CreatOurCar/monolith/device/hardware/monolith-mini/monolith-mini.kicad_pcb

## KiCad design device/hardware/monolith-mini/monolith-mini.kicad_pcb (2025-08-28, last stored version)

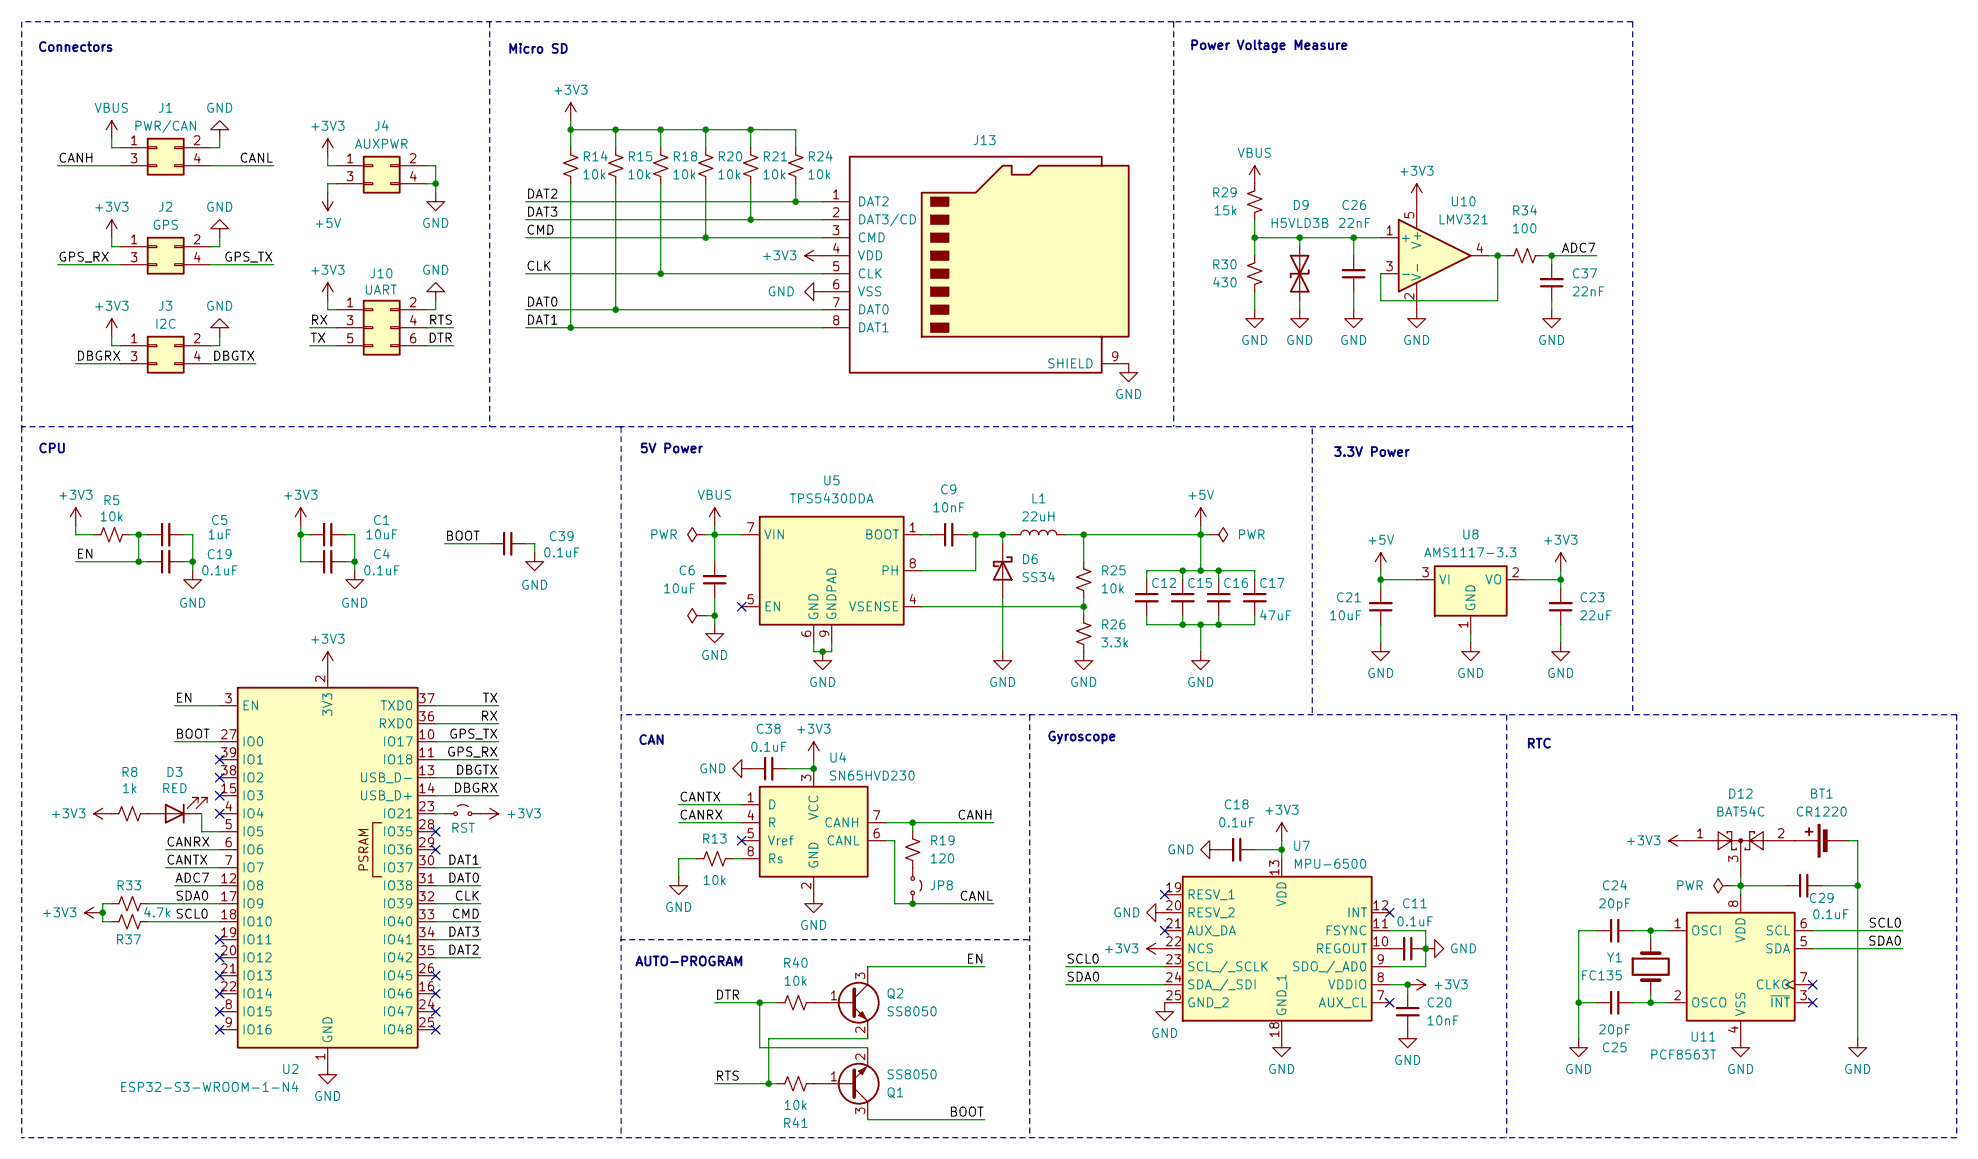
[picture p8: schematic monolith-mini.kicad_sch]

Parts:
BT1: CR1220; S8411-45R_1; Manufacturer_Part_Number CR1220-2; LCSC C70381
C1, C21: 10uF; C_0603_1608Metric; LCSC C19702
C4, C11, C18, C19, C29, C38, C39: 0.1uF; C_0603_1608Metric; LCSC C14663
C5: 1uF; C_0603_1608Metric; LCSC C15849
C6: 10uF; C_1206_3216Metric; LCSC C13585
C9, C20: 10nF; C_0603_1608Metric; LCSC C57112
C12, C15, C16, C17: 47uF; C_1206_3216Metric; LCSC C96123
C23: 22uF; C_0603_1608Metric; LCSC C59461
C24, C25: 20pF; C_0603_1608Metric; LCSC C1648
C26, C37: 22nF; C_0603_1608Metric; LCSC C21122
D3: RED; LED_0603_1608Metric; LCSC C2286
D6: SS34; D_SMA; LCSC C8678
D9: H5VLD3B; D_SOD-323; LCSC C20615805
D12: BAT54C; SOT-23; Manufacturer_Part_Number BAT54C; LCSC C37704
J1: PWR/CAN; Molex_Mini-Fit_Jr_5569-04A2_2x02_P4.20mm_Horizontal
J2: GPS; Molex_Mini-Fit_Jr_5569-04A2_2x02_P4.20mm_Horizontal
J3: I2C; Molex_Mini-Fit_Jr_5569-04A2_2x02_P4.20mm_Horizontal
J4: AUXPWR; Molex_Mini-Fit_Jr_5569-04A2_2x02_P4.20mm_Horizontal
J10: UART; PinHeader_2x03_P2.54mm_Vertical
J13: Micro_SD_Card; TF115BCP9; LCSC C393941
JP5: RST; PinHeader_1x02_P2.54mm_Vertical
JP8: CAN 120Ω; PinHeader_1x02_P2.54mm_Vertical
L1: 22uH; L_Sunlord_MWSA0603S; LCSC C177244
Q1, Q2: SS8050; SOT-23; LCSC C2150
R5, R13, R14, R15, R18, R20, R21, R24, R25, R40, R41: 10k; R_0603_1608Metric; LCSC C25804
R8: 1k; R_0603_1608Metric; LCSC C21190
R19: 120; R_0603_1608Metric; LCSC C22787
R26: 3.3k; R_0603_1608Metric; LCSC C22978
R29: 15k; R_0603_1608Metric; LCSC C22809
R30: 430; R_0603_1608Metric; LCSC C23170
R33, R37: 4.7k; R_0603_1608Metric; LCSC C23162
R34: 100; R_0603_1608Metric; LCSC C22775
U2: ESP32-S3-WROOM-1-N4; ESP32-S3-WROOM-1; LCSC C2913197
U4: SN65HVD230; SOIC-8_3.9x4.9mm_P1.27mm; LCSC C12084
U5: TPS5430DDA; TI_SO-PowerPAD-8_ThermalVias; LCSC C9864
U7: MPU-6500; QFN40P300X300X95-25N-D; Manufacturer_Part_Number MPU-6500; Mouser Part Number 410-MPU-6500
U8: AMS1117-3.3; SOT-223-3_TabPin2; LCSC C6186
U10: LMV321; SOT-23-5; LCSC C7972
U11: PCF8563T; SOIC-8_3.9x4.9mm_P1.27mm; LCSC C7440
Y1: FC135; Crystal_SMD_3215-2Pin_3.2x1.5mm; LCSC C32346

Connections:
+3V3: C1.1, C4.1, C18.1, C20.1, C23.2, C38.2, D12.1, J2.1, J3.1, J4.1, J10.1, J13.4 (VDD), JP5.2 (B), R5.2, R8.1, R14.2, R15.2, R18.2, R20.2, R21.2, R24.2, R33.1, R37.2, U2.2 (3V3), U4.3 (VCC), U7.8 (VDDIO), U7.13 (VDD), U7.22 (NCS), U8.2 (VO), U10.5 (V+)
+5V: C12.1, C15.1, C16.1, C17.1, C21.2, J4.3, L1.2, R25.2, U8.3 (VI)
/ADC7: C37.2, R34.2, U2.12 (IO8)
/BOOT: C39.1, Q1.3 (C), U2.27 (IO0)
/CANH: J1.3, R19.2, U4.7 (CANH)
/CANL: J1.4, JP8.2 (B), U4.6 (CANL)
/CANRX: U2.6 (IO6), U4.4 (R)
/CANTX: U2.7 (IO7), U4.1 (D)
/CLK: J13.5 (CLK), R18.1, U2.32 (IO39)
/CMD: J13.3 (CMD), R20.1, U2.33 (IO40)
/DAT0: J13.7 (DAT0), R15.1, U2.31 (IO38)
/DAT1: J13.8 (DAT1), R14.1, U2.30 (IO37)
/DAT2: J13.1 (DAT2), R24.1, U2.35 (IO42)
/DAT3: J13.2 (DAT3/CD), R21.1, U2.34 (IO41)
/DBGRX: J3.3, U2.14 (USB_D+)
/DBGTX: J3.4, U2.13 (USB_D-)
/DTR: J10.6, Q1.2 (E), R40.1
/EN: C5.1, C19.1, Q2.3 (C), R5.1, U2.3 (EN)
/GPS_RX: J2.3, U2.11 (IO18)
/GPS_TX: J2.4, U2.10 (IO17)
/RTS: J10.4, Q2.2 (E), R41.2
/RX: J10.3, U2.36 (RXD0)
/SCL0: R37.1, U2.18 (IO10), U7.23 (SCL_/_SCLK), U11.6 (SCL)
/SDA0: R33.2, U2.17 (IO9), U7.24 (SDA_/_SDI), U11.5 (SDA)
/TX: J10.5, U2.37 (TXD0)
GND: BT1.2 (-), C1.2, C4.2, C5.2, C6.1, C11.1, C12.2, C15.2, C16.2, C17.2, C18.2, C19.2, C20.2, C21.1, C23.1, C24.1, C25.1, C26.1, C29.2, C37.1, C38.1, C39.2, D6.2 (A), D9.2 (A2), J1.2, J2.2, J3.2, J4.2, J4.4, J10.2, J13.6 (VSS), J13.9 (SHIELD), R13.1, R26.1, R30.1, U2.1 (GND), U2.40 (GND), U2.41 (GND), U4.2 (GND), U5.6 (GND), U5.9 (GNDPAD), U7.9 (SDO_/_AD0), U7.11 (FSYNC), U7.18 (GND_1), U7.20 (RESV_2), U7.25 (GND_2), U8.1 (GND), U10.2 (V-), U11.4 (VSS)
unnamed: BT1.1 (+), D12.2
unnamed: D3.2 (A), R8.2
unnamed: D3.1 (K), U2.5 (IO5)
unnamed: C9.2, D6.1 (K), L1.1, U5.8 (PH)
unnamed: C26.2, D9.1 (A1), R29.1, R30.2, U10.1 (+)
unnamed: JP5.1 (A), U2.23 (IO21)
unnamed: JP8.1 (A), R19.1
unnamed: Q1.1 (B), R41.1
unnamed: Q2.1 (B), R40.2
unnamed: R13.2, U4.8 (Rs)
unnamed: C9.1, U5.1 (BOOT)
unnamed: R25.1, R26.2, U5.4 (VSENSE)
unnamed: C11.2, U7.10 (REGOUT)
unnamed: R34.1, U10.3 (-), U10.4
unnamed: C24.2, U11.1 (OSCI), Y1.1
unnamed: C25.2, U11.2 (OSCO), Y1.2
unnamed: C29.1, D12.3, U11.8 (VDD)
VBUS: C6.2, J1.1, R29.2, U5.7 (VIN)

Notes on the sheet:
CAN
AUTO-PROGRAM
Micro SD
Connectors
3.3V Power
RTC
Power Voltage Measure
CPU
Gyroscope
5V Power

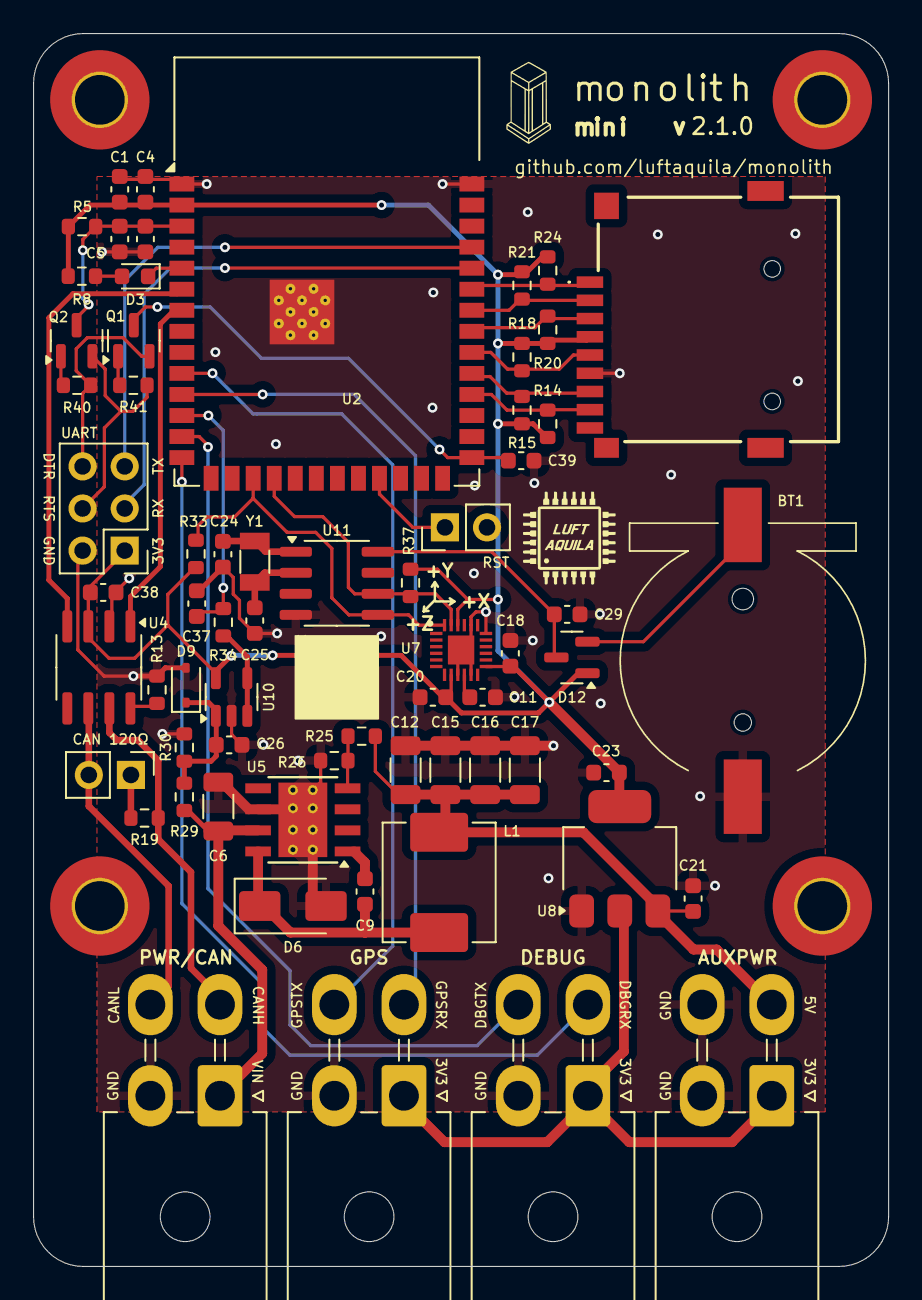
[picture p9: board monolith-mini.kicad_pcb from above]

Board: 2 copper layers, 51.6 x 74.4 mm, 65 parts (0 on the bottom side), 44 nets.
