CreatOurCar/monolith/(commit log)

2025-07-01 add: v2 schematics and footprints
    [monolith.kicad_pcb, monolith.kicad_sch]
2025-07-25 update: PCB prototype
    [monolith.kicad_pcb, monolith.kicad_sch]
2025-07-25 update: prototype PCB
    [monolith-CuBottom.gbr, monolith-CuTop.gbr, monolith-EdgeCuts.gbr, monolith-MaskBottom.gbr, monolith-MaskTop.gbr, monolith-NPTH.drl, monolith-PTH.drl, monolith-PasteBottom.gbr]
2025-07-25 update: replace MPU-6050 to MPU-6500
    [monolith-CuBottom.gbr, monolith-CuTop.gbr, monolith-EdgeCuts.gbr, monolith-MaskBottom.gbr, monolith-MaskTop.gbr, monolith-NPTH.drl, monolith-PTH.drl, monolith-PasteBottom.gbr]
2025-07-25 update: I2C2 to I2C0
    [monolith.kicad_pcb, monolith.kicad_sch]
2025-07-25 add: error handling system and NVS config management
    [main.c, main.h]
2025-07-25 add: STA mode prototype
2025-07-25 fix: wrong marking TX/RX on the PCB
    [monolith-CuBottom.gbr, monolith-CuTop.gbr, monolith-EdgeCuts.gbr, monolith-MaskBottom.gbr, monolith-MaskTop.gbr, monolith-NPTH.drl, monolith-PTH.drl, monolith-PasteBottom.gbr]
2025-07-25 fix: wrong LED direction
    [monolith-CuBottom.gbr, monolith-CuTop.gbr, monolith-EdgeCuts.gbr, monolith-MaskBottom.gbr, monolith-MaskTop.gbr, monolith-NPTH.drl, monolith-PTH.drl, monolith-PasteBottom.gbr]
2025-07-25 add: mqtt prototype
2025-07-25 improve: led and logging system
2025-07-25 impl: RST button reset NVS
    [main.c]
2025-07-25 improve: add reboot button on html
2025-07-25 improve: quit task after init and make period correct
    [main.c]
2025-07-25 fix: state shift bits
    [main.c, main.h]
2025-07-25 add: digital input prototype
2025-07-25 improve: error state management
    [analog.c, can.c, digital.c, gps.c, gyroscope.c, main.c, main.h, sdcard.c]
2025-07-25 fix: record initial digital state
    [digital.c]
2025-07-25 fix: sync log to sd card
    [sdcard.c]
2025-07-25 fix: wait next period on transfer failure too
    [gyroscope.c]
2025-07-25 update: use synchronous api on i2c transfer
2025-07-27 update: add sample uplot graph
2025-07-27 update: set responsive chart size sample
2025-07-28 add: protocol parser prototype
2025-07-28 add: refresh button
2025-08-01 impl: gyro chart
2025-08-01 update: skip current log file on ls and del/all
    [sdcard.c]
2025-08-01 add: current position button
2025-08-02 improve: checksum failure during analog measurement
    [analog.c, main.h]
2025-08-02 add: viewer prototype
2025-08-05 impl: gps prototype with pattern detection interrupt
2025-08-06 update: drop 115200 bps gps for stability
    [gps.c]
2025-08-06 fix: download filtering
2025-08-06 improve: retry on i2c failure
    [analog.c, main.c]
2025-08-07 improve: gps checksum fail
    [gps.c]
2025-08-09 improve: set gyro offset registers
2025-08-10 fix: reset gyro offset before calibrate
    [gyroscope.c]
2025-08-11 drop: geolocation button
2025-08-11 improve: gyro error recovery
    [gyroscope.c]
2025-08-11 fix: wrong button operation
2025-08-11 fix: reset prev alert
    [can.c]
2025-08-12 update: remove jumpers
    PCB v2.0.1
    [monolith-CuBottom.gbr, monolith-CuTop.gbr, monolith-EdgeCuts.gbr, monolith-MaskBottom.gbr, monolith-MaskTop.gbr, monolith-NPTH.drl, monolith-PTH.drl, monolith-PasteBottom.gbr]
2025-08-12 add: workflows
    [BOM-monolith.csv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]
2025-08-18 fix: GPS buffer overflow and add bitrate detection
    [analog.c, gps.c]
2025-08-24 improve: split time slot
2025-08-25 update: change FreeRTOS ticks to 50 Hz
2025-08-27 add: mini hardware
    [BOM-monolith-mini.csv, BOM-monolith.csv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]
2025-08-28 update: misc pcb changes
    [CPL-monolith-mini.csv, monolith-CuBottom.gbr, monolith-CuTop.gbr, monolith-EdgeCuts.gbr, monolith-MaskBottom.gbr, monolith-MaskTop.gbr, monolith-NPTH.drl, monolith-PTH.drl]
2025-11-10 Deploying to main from @ luftaquila/monolith@65aa01479936febd3e259b5cb4d91d847d5a2b51 🚀
2026-03-09 fix: CAN decoder idx mismatch with chart series order
    JS spec sorts integer object keys numerically, so can_decoder iteration
    order differs from views.can.view insertion order. Assign idx in
    can_decoder iteration order to match chart series building order.
2026-03-20 update: firmware performance optimization
    Scheduler & task model
    - FreeRTOS tick rate 50Hz → 1000Hz for 1ms resolution
    - Remove sync_slot mechanism; each sensor runs at independent intervals
    (gyro 100Hz, analog 50Hz/10Hz, CAN ~1kHz, GPS 10Hz)
    - Pin LWIP TCP/IP task to Core 0 to isolate sensor workloads
    Sensor drivers
    - ADC: pipelined convert → adc_start()/adc_read(), 7 channels in 4 cycles
    - GPS: integer-only fixed-point NMEA parser, eliminating atof/float
    - Gyroscope: stack-local log + memcpy to prevent data tearing
    Storage & buffering
    - SD fsync: hybrid write-count (512) + time-based (3s) instead of every 1s
    - SD drain interval 1000ms → 200ms
    - Log queue depth 2048 → 3072
    Syst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
    [analog.c, can.c, gps.c, gyroscope.c, main.h, sdcard.c]
2026-03-20 fix: SD fsync data loss, download speed no-op, Mini uninitialized payload
    [analog.c, sdcard.c]
2026-03-20 fix: web GUI bugs — divider typo, unit formatter, listener leak, null boot time
    - viewer: fix devider→divider typo causing voltage divider to never apply
    - viewer: fix ain2-ain6 series using ain1's unit formatter instead of own
    - viewer: fix ResizeObserver accumulation on repeated file uploads
    - viewer: add FileReader.onerror handler, remove unused Array.prototype
    - AppLayout: fix event listener leak (missing .value on ref) and null guard
    - mqtt: guard against null boot time in syslog, CAN, and telemetry handlers
    - telemetry: cap data arrays at 36000 points to prevent unbounded growth
    - telemetry: use container width for initial chart size instead of hardcoded 600px
    - telemetry: reduce i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
2026-03-20 fix: ISR-unsafe queue API, ADS1115 conversion margin, MQTT/TLS buffer sizing
    - digital ISR: split LOG into log_prepare + LOG/LOG_FROM_ISR to use
    xQueueSendFromISR in interrupt context instead of xQueueSend
    - ADS1115: increase conversion wait from 1200µs to 1400µs for reliable
    860SPS reads (was only 38µs margin, now 238µs)
    - MQTT buffer 4096→8192 for CAN batch publish headroom
    - TLS input buffer 16384→8192 to offset MQTT increase (cert chain is
    ~2.8KB, verified against production server)
    [analog.c, digital.c, main.h]
2026-03-20 fix: CLAUDE.md Mini sensor description and ESP-MQTT core affinity
2026-03-20 fix: skip MQTT init in AP mode to prevent TLS retry RAM exhaustion
    network_init() returns bool to indicate STA connection success.
    mqtt_init() is now conditional on network_init() returning true.
    Previously, AP mode would return from webserver() but still start
    MQTT, causing endless TLS reconnect attempts with no internet.
    [main.c]
2026-03-20 update: reduce WiFi RX buffers and enable mbedTLS dynamic buffer
    - WiFi static RX 10→4, dynamic RX 32→12 (RX-only, no TX impact)
    - mbedTLS SSL IN 8192→4096 (MQTT commands are small payloads)
    - mbedTLS dynamic buffer: free CA cert and config after handshake
2026-03-20 update: reduce logqueue depth 3072→2560 to free 12KB internal RAM
    200ms SD drain covers ~1913 msg at full 1Mbit/s CAN + all sensors,
    2560 provides ~647 entry margin for SD write latency spikes.
2026-03-20 update: replace DNS socket task with LWIP UDP callback in captive portal
    Removes dedicated dns_server task (2048B stack) and BSD socket overhead.
    UDP callback runs in LWIP context, saving ~3-4KB in AP mode.
2026-03-20 fix: clear DIGITAL fatal state on Mini variant
    Mini has no digital I/O, but logbuf.run initialized with
    ALL_ERROR_FATAL never gets DIGITAL bits cleared since task_digital
    is excluded by CONFIG_MONOLITH_MINI guard.
    [main.c]
2026-03-20 fix: I2C timeout too short (1ms→10ms) and add bus reset on failure
    [analog.c, gyroscope.c, main.c, main.h]
2026-03-21 fix: clear disabled sensor FATAL state
    [main.c]
2026-03-23 fix: live telemetry MQTT disconnect on long sessions
    Reduce main thread pressure that delayed keepalive pings:
    - Throttle chart scale updates to 1/s instead of every rAF (~60/s)
    - Cap GPS path array at 36000 points
    - Limit xterm scrollback to 5000 lines
    - Increase MQTT keepalive 10s→30s for more tolerance
2026-03-26 fix: GPS baud rate auto-detect using NMEA validation
    replace unreliable hardware pulse-based bitrate detection with
    sequential baud rate probing (115200→9600). also fix pattern queue
    desync on UART read failure path.
    [gps.c]
2026-03-26 add: GPS state monitoring (OK / comm error / module fatal)
    track NMEA validity and UART timeout to distinguish GPS module
    unresponsive (FATAL), communication error (ERROR), and normal
    no-fix waiting (OK without log output).
    [gps.c]
2026-03-26 add: GPS trail gradient with speed/time toggle
    replace static polyline with leaflet-hotline for gradient GPS trail.
    speed mode colors by velocity (green→red), time mode colors by
    recency (indigo→green). 1s debounced rebuild for 10Hz streaming.
2026-03-26 fix: restore per-frame chart scale update for smooth scrolling
2026-03-27 add: windowed chunk ack for file download flow control
2026-03-31 add: CAN decoder data filter with hex filter/mask matching
2026-03-31 update: sync docs with features added since v2.1.2
    - correct data rate from 10 Hz to up to 100 Hz
    - setup page auto-open on AP connection
    - GPS Fix/No Fix indicator and trail gradient modes (Speed/Time)
    - CAN statistics card in Data Viewer
    - CAN decoder Data Filter/Data Mask fields
    - rebuild docs HTML
2026-04-01 update: slim down mbedTLS config for reduced memory footprint
    Disable unused TLS server mode, certificate bundle, ECC curves,
    and features to free heap for HTTP client file upload.
2026-04-01 impl: replace MQTT chunk file download with HTTP PUT upload
    Device uploads files directly to server via HTTP PUT, freeing
    queues during transfer to reclaim heap. Server serves files via
    nginx WebDAV with auto-cleanup sidecar. Web fetches from server
    using nonce-based URLs instead of reassembling MQTT chunks.
    [can.c, main.h, sdcard.c]
2026-04-01 fix: clear CMAKE_C_FLAGS cache when switching between mini and original builds
2026-04-01 fix: handle d/ver retained message ordering on page refresh
    Use pending_ver to defer firmware version display until device
    online status is confirmed via d/boot, preventing stale retained
    d/ver from showing when device is offline.
2026-04-03 add: mqtt-proxy sidecar for real client IP in mosquitto logs
    HAProxy sidecar converts X-Real-IP header to PROXY protocol v2,
    enabling mosquitto to log actual client IPs instead of internal
    container network addresses.
    [mqtt-proxy.cfg]
2026-06-02 feat: COC 브랜딩 적용 및 로컬 Mosquitto 연결
2026-06-25 fix: SD card SDMMC 4-bit → SDSPI mode (SCK=39 MOSI=40 MISO=48 CS=41)
    SDMMC 4-bit 하드웨어 컨트롤러에서 SPI2 소프트웨어 방식으로 전환.
    GPIO38이 DevKitC-1 WS2812B와 충돌해 MISO를 GPIO48로 재배정.
    SPI 클럭은 배선 안정성을 위해 400kHz(SDMMC_FREQ_PROBING)로 설정.
    [sdcard.c]
2026-06-25 update: wheel diameter constants for vehicle speed calculation
    건조(40cm)/우천(50cm) 타이어 지름 상수 추가.
    DISPLAY_WET_TRACK 0/1 토글 하나로 노면 조건 전환.
    기어비 4.02 확정, 확인 필요 주석 제거.
2026-06-25 fix: WS2812B LED conflict, reassign I2C1 SCL GPIO48→42
    DevKitC-1 v1.1 WS2812B가 GPIO38에 연결돼 있어
    SDSPI MISO(GPIO38)와 충돌 → MISO를 GPIO48로 이동,
    WS2812B는 부팅 시 led_strip으로 명시 소등.
    I2C1 SCL을 GPIO48(WS2812B 데이터 핀)에서 GPIO42로 재배정.
    [analog.c, main.c]
2026-06-27 update: standardize ESP-IDF version to v6.0.1 across all docs and CI
    - CLAUDE.md: v5.5.1 → v6.0.1, add Windows PowerShell build note
    - CAN/CLAUDE.md: v5.5.1 → v6.0.1
    - firmware.yml: esp_idf_version v5.5 → v6.0.1 (both jobs)
    - docs/docs_en.md, docs/docs_ko.md: TWAI API link v5.4.2 → v6.0.1
    - README.md: add Development Environment section with required version warning
2026-06-27 update: refactor headers into include/, add ADS1115 wiring docs in analog.c
    - main/main.h removed; headers moved to main/include/ (main.h, config.h, protocol.h)
    - CMakeLists.txt: add include/ to INCLUDE_DIRS
    - analog.c: add ADS1115 module wiring comments (I2C addr, channel mapping, voltage warning)
    - docs/PINMAP.md: add firmware pinmap reference doc
2026-06-28 update: ADS1115 module2 A2/A3 → ain7/ain8, drop internal temp sensor
    Remap ADS1115 module2(0x49) channels: A2→ain7, A3→ain8.
    Rename analog_record_t fields voltage/temperature → ain7/ain8 (wire
    format and PROTOCOL_VERSION unchanged). Remove ESP32 internal temp
    sensor read from Original build; Mini branch retains it via ain8 slot.
    Update web (protocol.js, ui.js, viewer.vue, telemetry.js, telemetry.vue)
    and docs/PINMAP.md to match.
2026-06-29 remove: drop upstream-fork hardware and dead PCB references repo-wide
    Delete forked-upstream KiCAD hardware (device/hardware) and pcb.yml; strip PCB gerber packaging from release.yml; remove PCB/connector/jumper/sponsor sections from docs and README; drop FUNDING.yml. Firmware (.c/.h) untouched.
    [BOM-monolith-mini.csv, BOM-monolith.csv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]
2026-06-29 update: regenerate docs html after PCB removal
2026-06-29 add: document v1.1 board pinmap and GPIO usage
2026-07-01 remove: drop self-hosted web app and MQTT relay server
    Logs are stored to SD only and viewed on the upstream site
    (https://v2.monolith.luftaquila.io/), so the Vue web app and the
    mosquitto/nginx/mqtt-proxy relay stack are no longer used.
    [mqtt-proxy.cfg]
2026-07-01 update: strip firmware to an SD-only sensor logger (drop WiFi/MQTT + RTC)
    Keep only the sensor-acquisition → SD-recording path; remove the entire
    WiFi/MQTT/web-server relay and the external PCF8563 RTC.
    Network removal:
    - delete network/{mqtt,network,webserver}.c and the embedded assets
    (misc/index.html, isrgrootx1.pem); drop the espressif/mqtt and cjson
    managed-component deps
    - move the shared logbuf definition into main.c; remove the MQTT-only
    queues (syslog/canlog/cantx) and file_op_busy, keeping logqueue → SD
    - can.c keeps CAN→SD logging; drop remote CAN-TX and telemetry batching
    RTC → GPS clock:
    - replace the RTC read with a plain I2C0 bus init (still shared by the
    gyr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
    [can.c, gps.c, main.c, main.h, sdcard.c]
2026-07-01 update: document SD-only firmware and drop web/server references
    Rewrite CLAUDE.md/README and the project docs for the single-firmware
    (sensor + SD) system: GPS is the wall-clock source; WiFi/MQTT/web are
    gone; SD .log format stays compatible with the upstream viewer.
2026-07-01 remove: drop Mini variant, Original-only firmware
    Mini (CONFIG_MONOLITH_MINI) added compile-time branches for a compact
    board without ADS1115 analog modules or digital inputs. We only build
    and ship Original, so drop the Mini code paths, build target, and CI
    job to simplify the firmware to one variant.
    - analog.c: remove the Mini branch (internal temp sensor + ADC1_CH7
    voltage read); config.h: drop the Mini TASK_INTERVAL_ANALOG override
    - main.c: DIGITAL task is now created unconditionally
    - Makefile: drop the `mini` goal and its CMAKE_C_FLAGS injection
    - firmware.yml/release.yml: drop the Mini build job and release artifact
    - flash.sh/flash.ps1: drop the now-dead Mini menu option, always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
2026-07-01 web,mqtt 제거 후 workflow
2026-07-01 remove: drop dead MQTT/RTC/web leftovers and unread logbuf snapshots
    - config.h: delete unused MQTT_QOS enum and RTC-era BCD_TO_DEC/DEC_TO_BCD
    - main.h: drop unused CORE0/CORE1 enum and write-only wifi.macaddr field
    - main.h: slim log_buf_t to {run, digital}; gps/gyro/analog/timestamp were
    write-only snapshots left over from MQTT/web publishing (never read)
    - analog.c/gps.c/gyroscope.c: remove the dead logbuf memcpy running every sample
    - main/misc, main/network: remove empty leftover directories
    - protocol.h, CAN/CLAUDE.md: update stale web/MQTT docs to SD-only reality
    SD .log binary format unchanged (log_t layout, LOG_MAGIC, PROTOCOL_VERSION,
    checksum, BOOT-first order preserved); build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
2026-07-01 remove: drop unused EZ/Daly CAN ID macros
    CAN_EZ_ID2, CAN_DALY_ID93, CAN_DALY_ID98 were defined but never referenced.
    They only named IDs for the display path; all CAN frames are still logged to
    SD regardless of these constants, so removing them changes no behavior.
    Builds clean on ESP-IDF v6.0.1.
2026-07-02 update: raise tick rate to 1kHz, batch SD writes, harden GPS/CAN/analog timing
    - sdkconfig: FREERTOS_HZ 100 -> 1000 so ms-granularity sleeps used below
    (analog ADC wait, CAN poll) actually resolve at 1ms instead of 10ms
    - analog: replace busy-wait esp_rom_delay_us(1400) with vTaskDelay(2) +
    short spin for the remainder, freeing the CPU during ADS1115 conversion
    - can: block in twai_receive() with a timeout instead of busy-polling;
    check alerts at most every 100ms instead of every loop iteration
    - display: send both nibbles of a byte in a single I2C transaction
    instead of two, halving LCD I2C traffic on the shared gyro/LCD bus
    - gps: rewrite NMEA field tokenizer to bail out safely on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
    [analog.c, can.c, display.c, gps.c, sdcard.c]
2026-07-02 fix: debounce digital inputs, zero reserved log bytes, cut display I2C traffic
    - digital: replace per-edge ISR logging with ISR-notifies-task debouncing;
    mechanical switches bounce for several ms per press, so logging every raw
    edge flooded the log queue/SD with transient garbage. ISR now only wakes
    the task, which logs once on the first edge of a burst and once more when
    the inputs settle for 10ms. Record format/content unchanged.
    - main.h: drop now-unused LOG_FROM_ISR (digital.c no longer logs from ISR
    context); guard led_refresh() against a NULL led handle so a failed LED
    task creation doesn't crash SET_ERROR/CLEAR_ERROR/etc via xTaskAbortDelay
    - can: zero-fill the data array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
    [can.c, digital.c, display.c, gyroscope.c, main.h, sdcard.c]
2026-07-02 update: flatten nvs_storage_t wifi/device groups, sync workflow doc
    - nvs_storage_t: drop the leftover wifi{mac}/device{tz} nesting now that
    there's no WiFi config alongside them; mac/tz are top-level fields
    - workflow.md: document the debounce/framebuffer-diff/batched-write/
    reserved-byte-zeroing changes from the last two commits
